adafruit/Adafruit-CAN-Bus-BFF-PCB/Adafruit CAN Bus BFF.brd

## EAGLE design Adafruit CAN Bus BFF.brd (2024-01-26)

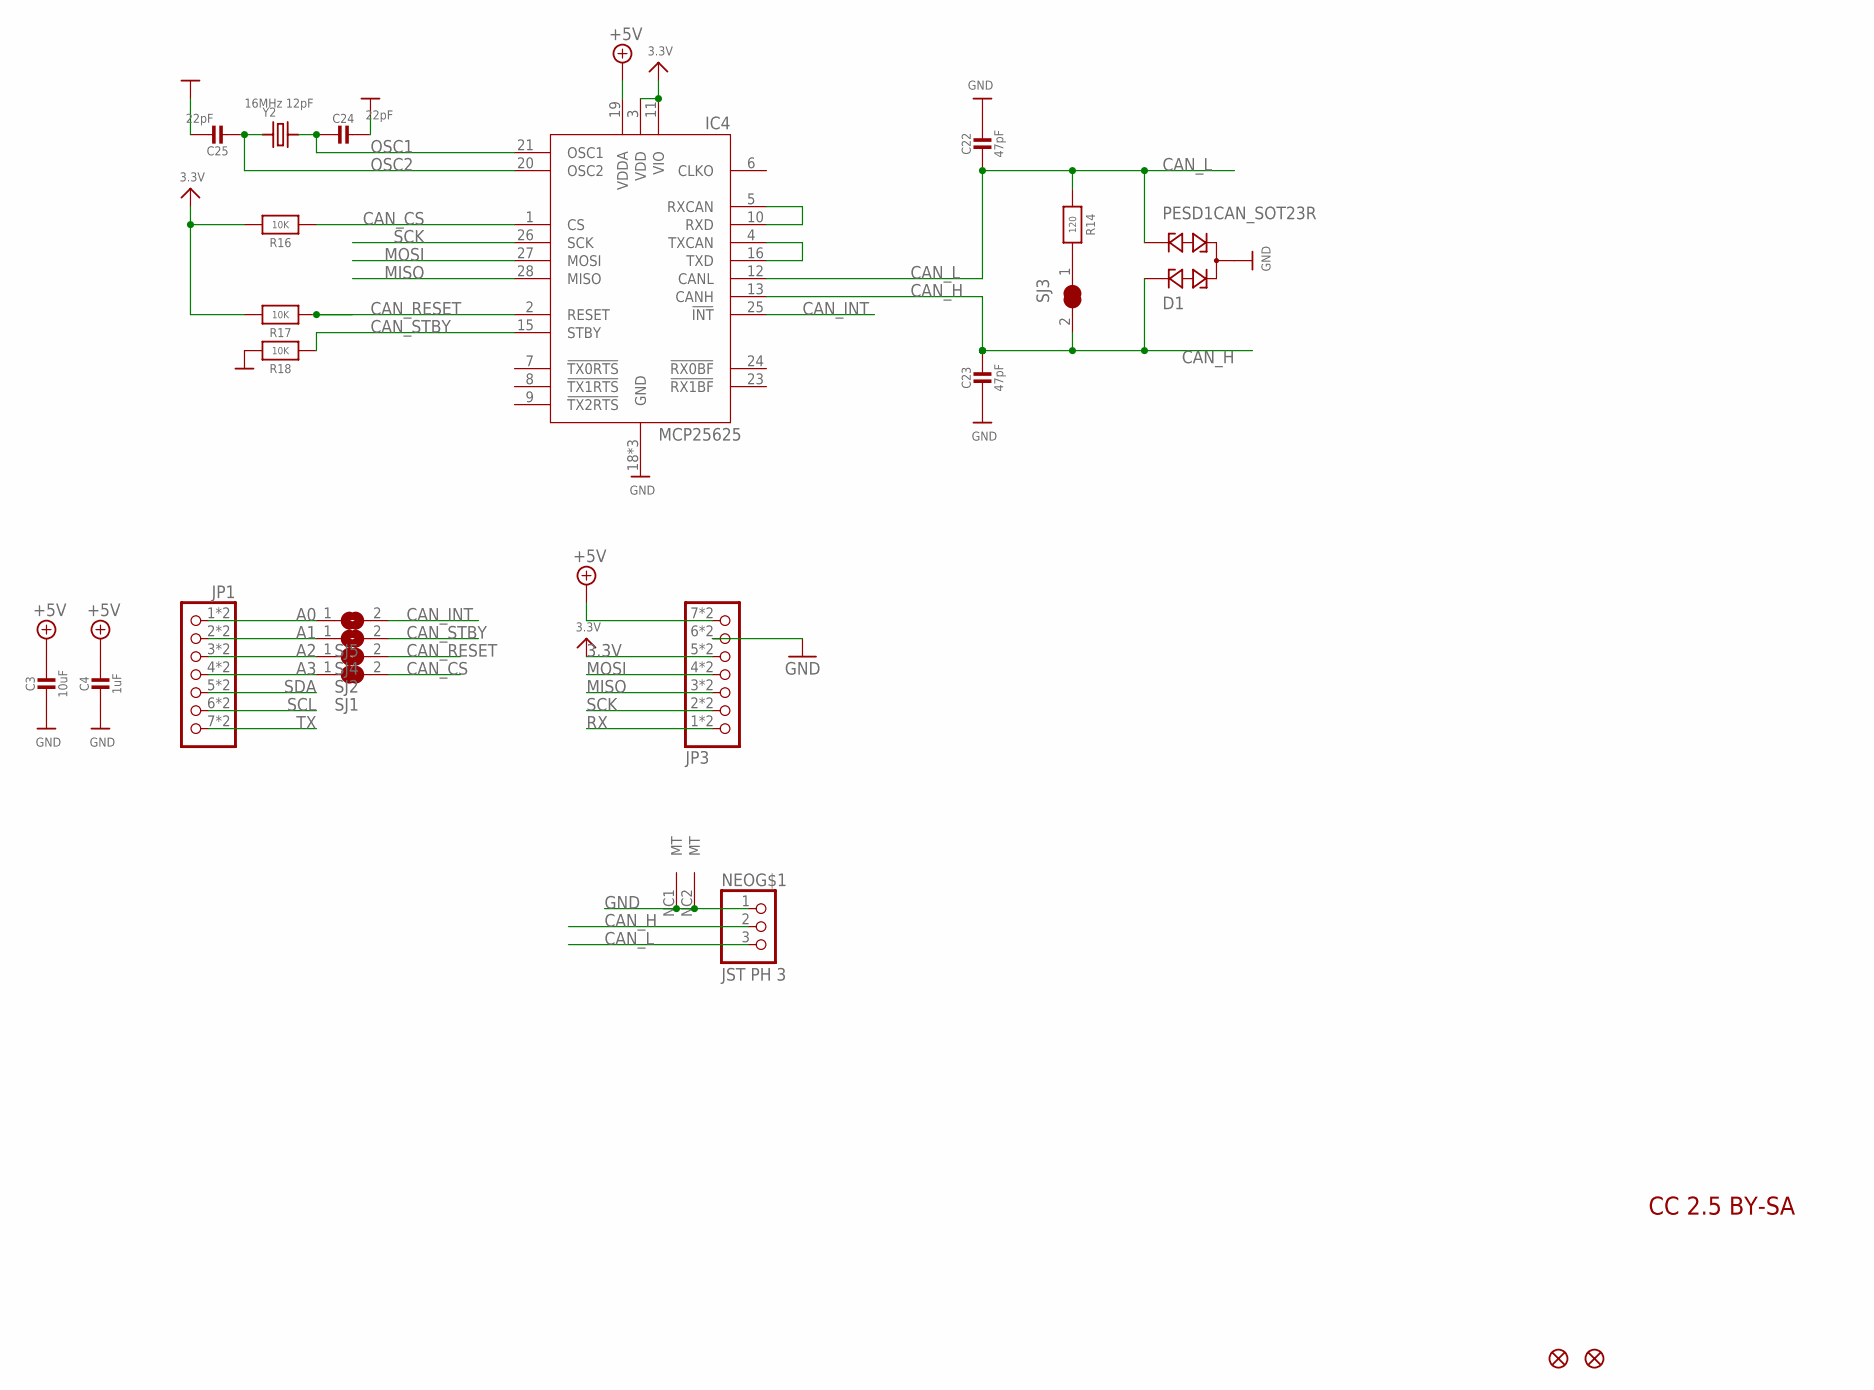
[picture p2: schematic Adafruit CAN Bus BFF.sch]

Parts:
C3: 10uF; 0805-NO
C4: 1uF; 0603-NO
C22, C23: 47pF; _0402NO
C24, C25: 22pF; _0402NO
D1: PESD1CAN_SOT23R; SOT23-R
IC4: MCP25625; QFN28-ML_6X6MM
JP1, JP3: HEADER-1X7_CASTEL; 1X07_CASTEL
NEO: JST PH 3; JSTPH3
R14: 120; _0402NO
R16, R17, R18: 10K; _0402NO
SJ1, SJ3: SOLDERJUMPER_CLOSED; SOLDERJUMPER_CLOSEDWIRE
SJ2, SJ4, SJ5: SOLDERJUMPER; SOLDERJUMPER_ARROW_NOPASTE
U$6, U$8: FIDUCIAL_1MM
Y2: 16MHz 12pF; CRYSTAL_2.5X2

Connections:
3.3V: IC4.3 (VDD), IC4.11 (VIO), JP3.5, JP3.5C (5), R16.2, R17.2
+5V: C3.1, C4.1, IC4.19 (VDDA), JP3.7, JP3.7C (7)
A0: JP1.1, JP1.1C (1), SJ5.1
A1: JP1.2, JP1.2C (2), SJ4.1
A2: JP1.3, JP1.3C (3), SJ2.1
A3: JP1.4, JP1.4C (4), SJ1.1
CAN_CS: IC4.1 (CS), R16.1, SJ1.2
CAN_H: C23.1, D1.1, IC4.13 (CANH), NEO.2, SJ3.2
CAN_INT: IC4.25 (!INT), SJ5.2
CAN_L: C22.2, D1.2, IC4.12 (CANL), NEO.3, R14.1
CAN_RESET: IC4.2 (RESET), R17.1, SJ2.2
CAN_STBY: IC4.15 (STBY), R18.1, SJ4.2
GND: C3.2, C4.2, C22.1, C23.2, C24.1, C25.1, D1.3, IC4.18 (GND), IC4.22 (GND), IC4.EXP (GND), JP3.6, JP3.6C (6), NEO.1, NEO.NC1 (MT), NEO.NC2 (MT), R18.2
MISO: IC4.28 (MISO), JP3.3, JP3.3C (3)
MOSI: IC4.27 (MOSI), JP3.4, JP3.4C (4)
unnamed: R14.2, SJ3.1
unnamed: IC4.5 (RXCAN), IC4.10 (RXD)
unnamed: IC4.4 (TXCAN), IC4.16 (TXD)
OSC1: C24.2, IC4.21 (OSC1), Y2.3 (2)
OSC2: C25.2, IC4.20 (OSC2), Y2.1
RX: JP3.1, JP3.1C (1)
SCK: IC4.26 (SCK), JP3.2, JP3.2C (2)
SCL: JP1.6, JP1.6C (6)
SDA: JP1.5, JP1.5C (5)
TX: JP1.7, JP1.7C (7)

Notes on the sheet:
CC 2.5 BY-SA

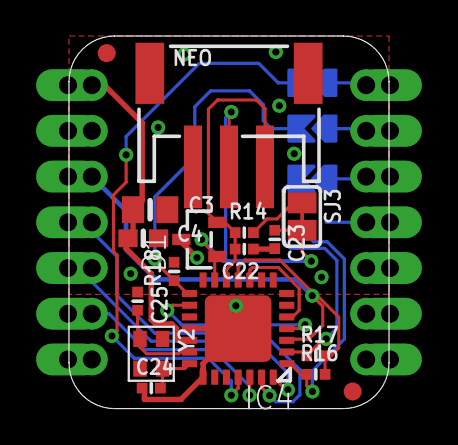
[picture p3: board Adafruit CAN Bus BFF.brd from above]

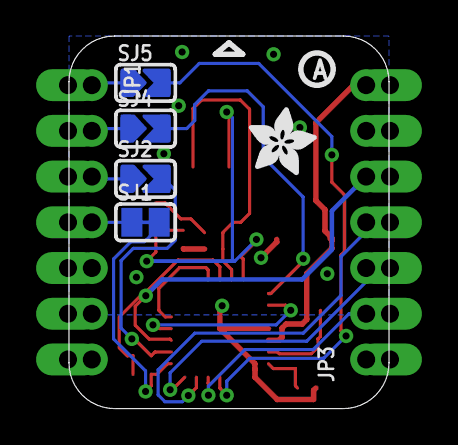
[picture p4: board Adafruit CAN Bus BFF.brd from below]

Board: 2 copper layers, 17.8 x 20.7 mm, 49 parts (15 on the bottom side), 25 nets.

Other parts of the board:
PLABEL1: PLABEL1
PLABEL2: PLABEL2
PLABEL3: PLABEL3
PLABEL4: PLABEL4
PLABEL5: PLABEL5
PLABEL6: PLABEL6
PLABEL7: PLABEL7
PLABEL8: PLABEL8
PLABEL9: PLABEL9
PLABEL11: PLABEL11
PLABEL12: PLABEL12
PLABEL13: PLABEL13
PLABEL14: PLABEL14
PLABEL19: PLABEL19
PLABEL20: PLABEL20
PLABEL21: PLABEL21
PLABEL22: PLABEL22
PLABEL23: PLABEL23
PLABEL24: PLABEL24
PLABEL25: PLABEL25
PLABEL26: PLABEL26
PLABEL27: PLABEL27
PLABEL28: PLABEL28
PLABEL29: PLABEL29
U$3: PCBFEAT-REV-040
U$5: ADAFRUIT_3.5MM
